simulationsys/citadel/ml/vision/README.md

# Vision ML

Owns crop-specific disease/pest data, lightweight model training, evaluation, and TensorFlow Lite export for the edge device.

Keep raw images out of Git. Version datasets and record the crop, disease classes, and validation metrics with every exported model.
