simulationsys/citadel/docs/CITADEL-SOLUTION-OVERVIEW.md

# Citadel: Complete Solution Overview

## 1. Executive summary

Citadel is an offline-first, AI-assisted smart farming system designed to help farmers understand field conditions early, make better crop-care decisions, and operate irrigation more safely.

The solution combines physical field sensors, cameras, a local edge-computing unit, crop-health AI, pest and environmental-risk intelligence, a farmer mobile application, and an operational web dashboard into one connected system.

Citadel is not merely a sensor dashboard and it is not merely a crop-disease classifier. It creates a complete decision loop:

> Observe the farm, understand the risk, explain what is happening, recommend the next action, obtain human approval where necessary, and verify the result.

The system is designed for farms where internet connectivity may be slow, intermittent, expensive, or completely unavailable. Its essential functions operate locally. Internet connectivity improves synchronization and remote visibility, but the farmer does not lose the core system when the cloud is unavailable.

---

## 2. The problem Citadel addresses

Farm decisions are often made using delayed, incomplete, or disconnected information.

A farmer may notice dry soil only after plants begin showing stress. Crop disease may be recognized only after visible spread. Pest activity may be treated broadly because its source or severity is unclear. Irrigation may depend on habit rather than current soil, rainfall, heat, and water conditions. Existing smart-farming products can also become unusable when internet connectivity fails.

Several underlying problems occur together:

- Field conditions change continuously, but manual inspection is periodic.
- Sensor readings are difficult to interpret without context.
- Disease and pest symptoms may be noticed too late.
- Different tools provide separate readings without producing one clear recommendation.
- Cloud-dependent systems fail in low-connectivity agricultural areas.
- Automated irrigation can become dangerous if recommendations directly control hardware.
- Small and medium farmers need clear actions, not complex analytics.
- Farm managers need a broader operational view than an individual farmer needs.

Citadel addresses these problems as one connected system rather than as isolated features.

---

## 3. The proposed solution

Citadel places a small field node near the crop and a local computing unit, such as a Raspberry Pi, at the farm.

The field node measures conditions such as:

- Soil moisture
- Temperature
- Humidity
- Rainfall or rain conditions
- Tank, channel, or local water level
- Relay and irrigation state

A camera or farmer phone provides crop and pest images. The local computing unit receives this information and combines it using three forms of intelligence:

1. Environmental risk analysis
2. Crop-health image analysis
3. Pest detection or activity analysis

The farmer receives a simple explanation and recommended action through the mobile application. A farm manager or evaluator can see the same underlying farm state through a dashboard with additional history and operational context.

The cloud is optional for the immediate farm loop. When connectivity returns, selected records can synchronize for backup, multi-farm reporting, and remote access.

---

## 4. The complete Citadel loop

```text
Field conditions
      |
      v
Sensors and cameras collect evidence
      |
      v
Local edge unit stores and interprets the evidence
      |
      +--> Environmental risk intelligence
      +--> Crop-health AI
      +--> Pest intelligence
      |
      v
Citadel produces an explainable advisory
      |
      +--> Farmer mobile app: immediate action
      +--> Web dashboard: monitoring and history
      |
      v
Farmer reviews or approves the action
      |
      v
Field hardware performs the approved action
      |
      v
Hardware reports what actually happened
      |
      v
Citadel verifies the outcome and continues monitoring
```

This closed loop is the central idea of Citadel. The system does not stop at collecting data or generating a prediction. It connects observation, decision, action, and verification.

---

## 5. Who the solution serves

### 5.1 Farmer

The farmer is the primary user. The mobile application answers four practical questions:

- What is happening in my field?
- How urgent is it?
- Why is Citadel warning me?
- What should I do next?

The farmer should be able to understand the most important information within a few seconds, without needing to interpret raw sensor charts or machine-learning terminology.

### 5.2 Farm manager or cooperative operator

The dashboard supports someone responsible for a wider operational view. This user may need to compare zones, review recent readings, see alert history, confirm whether devices are online, and monitor irrigation decisions.

### 5.3 Agronomist or agricultural advisor

An advisor can use Citadel's evidence and history to support a more informed inspection. Citadel does not replace expert diagnosis; it helps direct attention earlier and provides the environmental context around a crop-health event.

### 5.4 System or hardware operator

The operator installs sensors, calibrates devices, checks connectivity, maintains the edge unit, and verifies that the relay and pump remain safe during failures.

---

## 6. Hardware scope

### 6.1 ESP32 field node

The ESP32 is the local field controller. It gathers environmental measurements, identifies the device and field zone, and communicates with the local edge unit.

Its purpose is deliberately narrow:

- Read sensors reliably
- Apply calibration
- Detect sensor failure
- Send normalized measurements
- Receive an approved irrigation command
- Control the relay safely
- Report whether the command was actually executed
- Continue sensing during temporary network loss

The ESP32 is not expected to run the main AI models or independently prescribe treatment.

### 6.2 Environmental sensors

Citadel proposes a modular set of sensors so the system can adapt to the farm and available hardware.

Core inputs include:

- A capacitive soil-moisture sensor for water-stress detection
- A temperature and humidity sensor for heat and disease-risk context
- A water-level sensor for tank, channel, or flood monitoring
- A rainfall input when available

The values are treated as evidence, not as unquestionable truth. Sensors must be calibrated and missing sensors must be shown as unavailable rather than replaced with believable-looking values.

### 6.3 Camera system

Citadel can receive images from:

- The farmer's phone
- An ESP32-CAM
- A Raspberry Pi camera
- A fixed pest-trap or canopy camera

Different camera placements serve different purposes. A close leaf image is appropriate for crop-health classification, while a wider fixed view may support pest monitoring.

The image path includes a quality check. Dark, blurry, overexposed, corrupt, or unsuitable images should lead to a recapture request, not a confident diagnosis.

### 6.4 Raspberry Pi or edge computer

The edge computer is the local brain of Citadel. It connects the hardware, AI, storage, applications, and optional cloud.

It is responsible for:

- Receiving readings and images
- Storing recent farm history
- Running local AI
- Combining environmental and visual evidence
- Producing advisories
- Serving the mobile app and dashboard over the local network
- Recording irrigation requests and approvals
- Returning commands to the correct field node
- Synchronizing data when internet access becomes available

The system can initially run on a laptop during development and later move to a Raspberry Pi without changing the overall user experience.

### 6.5 Relay and irrigation equipment

The relay represents the bridge from software advice to a physical action such as switching a pump.

Citadel proposes a human-in-the-loop control model:

1. The system detects a possible irrigation need.
2. Citadel explains the evidence.
3. The farmer reviews the recommendation.
4. The farmer approves or declines it.
5. Only an approved request becomes a command.
6. The field node executes the command.
7. The field node reports the actual relay state.

The safe default is OFF. A recommendation alone must never activate the pump.

---

## 7. Farmer mobile application

The mobile app is Citadel's primary action surface. It is designed around clarity, local use, and weak-connectivity conditions.

### 7.1 Home experience

The home screen presents:

- Current connection and freshness status
- The most urgent advisory
- Essential field measurements
- Quick access to crop scanning
- Irrigation recommendations requiring attention
- Recent changes or important events

Urgent action appears before detailed analytics.

### 7.2 Advisory experience

Each advisory should contain:

- A recognizable category
- Severity or urgency
- A short title
- A plain-language explanation
- The evidence that triggered it
- A suggested next action

For example, Citadel should not only say "Heat risk." It should explain that temperature is high while soil moisture is low and suggest inspection or irrigation during cooler hours.

### 7.3 Crop scan experience

The farmer can capture or select a crop image. Citadel then:

1. Checks whether the image is usable.
2. Runs the appropriate local model.
3. Returns the possible condition and confidence.
4. Clearly communicates uncertainty.
5. Suggests inspection, recapture, or another next step.

The language should remain cautious. A model result is a decision-support signal, not a final agronomic diagnosis.

### 7.4 Irrigation approval experience

When irrigation is recommended, the farmer can inspect the evidence and approve or decline the request.

The interface must distinguish between:

- Recommended
- Approved
- Command sent
- Confirmed by hardware
- Completed or stopped

This prevents the app from claiming that irrigation occurred merely because a button was pressed.

### 7.5 History

The history view helps the farmer understand recent alerts and actions:

- Environmental warnings
- Crop scans
- Pest observations
- Irrigation requests
- Approved or declined actions
- Device or connectivity changes

History is supportive rather than the main focus.

### 7.6 Settings and local connection

The app allows the local edge address and zone to be configured. This lets the farmer's phone connect directly to the Raspberry Pi over farm Wi-Fi without needing public internet access.

Future versions can add Hindi and other regional languages, larger accessibility options, voice guidance, and notifications.

---

## 8. Web dashboard

The web dashboard is the operational view of the same farm intelligence shown in the farmer app.

It is intended for a farm manager, cooperative operator, technical operator, evaluator, or demonstration audience.

The dashboard presents:

- Current sensor readings
- Field or zone status
- Data freshness
- Active advisories
- Latest crop-health observation
- Irrigation and relay state
- Recent reading history
- Device connectivity and service health

The dashboard does not create its own agricultural rules. It displays the same authoritative state and advisories produced by the edge system. This keeps mobile and web recommendations consistent.

Its broader screen size makes it appropriate for trends, comparisons, operational status, and demonstrations. The farmer app remains the simpler field-action experience.

---

## 9. Crop-health AI

Citadel's crop-health intelligence focuses on a credible, limited Phase 1 scope rather than claiming universal crop diagnosis.

The current proposal focuses on tomato leaf health, including categories such as:

- Healthy
- Early blight
- Late blight
- Leaf spot
- Yellow leaf curl virus

The model is designed for local inference so a crop scan can work without a cloud request.

### 9.1 Responsible prediction flow

Before classification, Citadel checks:

- Image resolution
- Brightness
- Overexposure
- Blur
- Whether the image appears to contain a suitable leaf

After prediction, Citadel applies a confidence policy:

- High confidence: present the likely condition with normal caution
- Medium confidence: qualify the result and recommend a clearer close-up or inspection
- Low confidence: return an inconclusive result instead of forcing a disease label
- Invalid image: explain why the image cannot be analyzed

The output becomes one source of evidence for the advisory engine. It does not directly prescribe pesticide use.

---

## 10. Pest intelligence

The pest component is intended to identify or estimate visible pest activity from an image.

Depending on the final model and camera setup, the result may contain:

- Pest category
- Confidence
- Estimated count
- Activity level
- Affected zone
- Image timestamp

Citadel converts this into restrained advice such as inspecting affected plants or using targeted intervention after confirmation.

The system should not claim that a pest model is operational when its trained artifact and matching labels have not been installed and validated. Until that point, the pest feature remains a defined integration capability rather than a production-ready diagnosis.

---

## 11. Environmental-risk intelligence

Citadel combines multiple signals instead of interpreting every sensor independently.

The initial risk categories are:

### 11.1 Irrigation need

Low soil moisture can generate an irrigation recommendation. The farmer is asked to inspect and approve rather than having the pump start automatically.

### 11.2 Heat stress

High temperature combined with dry soil indicates a stronger stress condition than either signal alone. Citadel can recommend inspection and irrigation during a cooler period.

### 11.3 Flood or excess-water risk

High water level or intense rainfall takes priority over irrigation advice. Citadel warns the farmer to inspect drainage and avoid further watering.

### 11.4 Humidity-supported disease risk

Warm, humid conditions can increase disease risk. Citadel recommends inspecting leaves rather than claiming disease solely from environmental conditions.

### 11.5 Pest activity

A sufficiently confident pest observation can create a targeted inspection advisory. Weak detections should not produce strong recommendations.

### 11.6 Combined evidence

The major value comes from combining evidence. For example:

- Dry soil plus high heat produces a stronger heat-stress warning.
- Rain or high water suppresses an otherwise plausible irrigation recommendation.
- Warm humidity plus a suspicious crop image increases the need for inspection.
- A visual pest observation becomes more useful when attached to a specific zone and time.

The current thresholds are demonstration values and must eventually be calibrated for crop, soil, climate, irrigation method, and local agricultural guidance.

---

## 12. Explainability

Citadel is designed to show why it produced an advisory.

Every recommendation should be traceable to evidence such as:

- Soil moisture value
- Temperature and humidity
- Rainfall or water level
- Crop-health label and confidence
- Pest observation and count
- Time and affected zone

This is important because farmers should not be asked to trust a black-box instruction that could affect crops, water use, or equipment.

The system's language should communicate possibility, confidence, and limitations. It should encourage verification before expensive or irreversible treatment.

---

## 13. Offline-first design

Offline-first is a defining property of Citadel, not a fallback added later.

The farm's essential loop is local:

- Sensors communicate with the edge unit over the farm network.
- AI runs on the edge unit.
- Recent data is stored locally.
- The app connects to the edge unit over LAN.
- The dashboard is served locally.
- Advisories are generated locally.
- Irrigation approval does not require the cloud.

If internet access disappears, the system should continue sensing, analyzing, displaying, and controlling approved local actions.

The mobile app retains the last known farm state so it does not become blank during a temporary connection failure. However, cached information must be visibly marked as stale or offline.

When connectivity returns, queued records can synchronize to the cloud without being duplicated.

---

## 14. Cloud role

The cloud is a secondary coordination layer, not the immediate farm brain.

Its proposed responsibilities include:

- Backup of farm events
- Multi-farm visibility
- Remote monitoring
- Aggregated trends
- Long-term history
- Fleet and device management
- Model/version coordination
- Notifications outside the local network

Data created while offline remains on the edge until synchronization becomes possible. Stable event identities allow the cloud to recognize retries and avoid counting the same event twice.

If the cloud is unavailable, the farm should continue operating locally.

---

## 15. Data and information model

Citadel organizes farm information around a few consistent concepts.

### Farm

The overall agricultural location or operational unit.

### Zone

A field, greenhouse section, plot, bed, or monitored area. Every reading, observation, advisory, and command should be associated with the correct zone.

### Device

A stable identity for the physical sensor or camera node.

### Reading

A time-stamped collection of environmental sensor measurements.

### Observation

An AI or external observation such as a crop-health result or pest detection.

### Advisory

An explainable interpretation of readings and observations, including urgency and a suggested next action.

### Irrigation request

A recorded proposal to irrigate. It can remain pending, be approved, be declined, expire, or be completed.

### Actuator state

Citadel distinguishes the state the system wants from the state the hardware actually reports. This difference helps detect failures.

### Event identity

A stable identifier allows retried readings and synchronized records to remain idempotent rather than creating duplicates.

---

## 16. Safety model

Agricultural automation affects physical equipment, water, electricity, and crops. Citadel therefore separates intelligence from authority.

### 16.1 Advice does not equal actuation

The AI and risk engine may recommend irrigation, but they cannot directly turn on the pump.

### 16.2 Human approval

Irrigation requires an explicit approval step unless a future, separately controlled automatic mode is deliberately introduced.

### 16.3 Safe startup

The relay and pump must default to OFF during boot, restart, disconnection, or uncertain state.

### 16.4 Runtime limit

An irrigation command should contain a maximum runtime. The field node must stop the pump after that time even if communication with the edge unit is lost.

### 16.5 Desired versus reported state

The dashboard must not claim that a pump is running only because the backend requested it. The field node must acknowledge what it actually executed.

### 16.6 Sensor failure

A failed sensor should be marked unavailable. Citadel must not convert missing temperature, moisture, or water data into a realistic default and then generate advice from it.

### 16.7 AI uncertainty

Low-quality or low-confidence images produce an inconclusive result or recapture request. They must not create confident diagnoses.

### 16.8 Treatment boundary

Citadel recommends inspection and targeted action. It does not independently prescribe chemical treatment.

---

## 17. Failure behavior

Citadel proposes predictable behavior for common failures.

| Failure | Expected Citadel behavior |
| --- | --- |
| Internet unavailable | Continue the complete local farm loop |
| Cloud unavailable | Queue synchronization and retry later |
| Edge unit temporarily unreachable | Field node continues sampling and retries |
| Phone loses the edge connection | Show the last known state as stale, not live |
| Sensor fails | Mark it unavailable and exclude it from rules requiring that sensor |
| Image is poor | Request a better image |
| Crop model unavailable | Report that analysis is unavailable |
| Pest model unavailable | Report that the model is not ready |
| Duplicate reading | Accept safely without storing it twice |
| Irrigation command is not acknowledged | Show a desired/reported mismatch and keep the system safe |
| Edge unit crashes during irrigation | Field node runtime limit stops the pump |
| Hardware restarts | Relay returns to OFF |

---

## 18. End-to-end user journeys

### 18.1 Dry-soil journey

1. The soil sensor detects low moisture.
2. The ESP32 sends the reading to the edge unit.
3. Citadel checks rainfall, water level, and heat before recommending irrigation.
4. The app shows an irrigation warning and its evidence.
5. The farmer inspects the field.
6. The farmer approves or declines the request.
7. If approved, the command reaches the field node.
8. The field node activates the relay for a limited period.
9. The node reports the relay state.
10. Later readings show whether soil moisture improved.

### 18.2 Crop-disease journey

1. The farmer notices a suspicious leaf.
2. The farmer captures a close-up image in the app.
3. Citadel checks image quality.
4. The local crop model returns a likely class and confidence.
5. The result is combined with environmental context.
6. The farmer receives a cautious inspection advisory.
7. The observation enters local history for later comparison or expert review.

### 18.3 Pest journey

1. A farmer or fixed camera captures possible pest activity.
2. Citadel validates the image and runs the installed pest model.
3. The detection is attached to a zone and time.
4. Weak evidence is ignored or shown as uncertain.
5. Stronger evidence creates a targeted inspection advisory.
6. The farmer verifies the affected plants before treatment.

### 18.4 Flood-risk journey

1. Rainfall or water level rises.
2. Citadel identifies excess-water risk.
3. Flood risk takes priority over dry-soil irrigation logic.
4. The farmer receives a critical drainage warning.
5. Irrigation is avoided while the risk remains.

### 18.5 Offline journey

1. Internet access disappears.
2. Sensors continue sending data to the local edge unit.
3. Local AI and advisories continue operating.
4. The farmer app and dashboard remain available on the farm network.
5. Records accumulate locally.
6. When the internet returns, pending records synchronize to the cloud.

---

## 19. Current physical and product status

### Hardware currently demonstrated

- ESP32-WROOM-32 field-node foundation
- DHT11 temperature/humidity sensor wired and tested
- HC-SR04 water-level sensor wired through a voltage divider and tested
- Relay control side wired and tested
- Relay held OFF on boot
- Sensor JSON visible through the serial monitor

### Hardware still pending

- Capacitive soil-moisture sensor purchase, wiring, and calibration
- Rainfall-sensor decision and integration
- Raspberry Pi arrival and deployment
- Physical pump/load integration
- Final relay terminal and polarity verification before pump use
- Wi-Fi transmission from the ESP32 to the edge unit
- Command acknowledgement and hardware runtime protection
- Camera-node integration

### Mobile app currently represented

- Farmer-focused Flutter application
- Home, advisory, scan, history, profile, and settings experiences
- Configurable edge address and zone
- Live-repository structure with cached-state fallback
- Mock fallback for demonstrations and interface development

The complete phone-to-edge journeys still require final end-to-end contract verification with the consolidated backend and physical device.

### Dashboard currently represented

- Local browser dashboard
- Sensor and advisory presentation
- Crop-health and irrigation demo controls
- Same-origin operation from the edge service

### Crop-health AI currently represented

- Tomato-focused MobileNetV2/TensorFlow Lite artifacts
- Five crop-health classes
- Image-quality gate
- Confidence and limitation policy
- Training, evaluation, and audit artifacts

### Pest intelligence currently represented

- Pest inference adapter and integration boundary
- Risk rules capable of consuming pest observations
- Honest unavailable state when no final pest artifact is installed

The final pest detector and matching labels remain required for real pest inference.

### Edge and cloud currently represented

- Consolidated Python-based edge service
- Local persistent event storage
- Farm-state, readings, observations, history, crop-health, irrigation, and actuator flows
- Delayed edge-to-cloud synchronization boundary
- Cloud-side idempotent batch ingestion
- Backend test and CI coverage

---

## 20. MVP scope

The credible Citadel MVP should demonstrate one complete, reliable farm loop rather than a large number of incomplete features.

The MVP includes:

- One farm and at least one zone
- One functioning ESP32 field node
- Temperature and humidity readings
- Soil-moisture reading after sensor integration
- Water-level or rainfall risk input
- Local edge processing
- Tomato crop-health scan
- Environmental advisories
- Mobile display of farm state and urgent action
- Web dashboard display of the same state
- Human-approved relay demonstration using a safe test load
- Offline operation without public internet
- Optional delayed cloud synchronization

The MVP does not need to claim:

- Universal crop support
- Fully autonomous irrigation
- Agronomist-grade diagnosis
- Production-ready chemical recommendations
- Large multi-farm fleet management
- A completed pest model before a validated artifact exists
- Fully weatherproof, solar-powered field deployment

---

## 21. Demonstration narrative

A strong demonstration should tell one continuous story.

1. Show the physical field node and live sensor values.
2. Show the same values arriving at the local Citadel edge unit.
3. Open the farmer app and dashboard to prove both receive one shared farm state.
4. Create a dry-soil scenario and show an explainable irrigation recommendation.
5. Show that the relay remains unchanged until the farmer approves.
6. Approve the request and demonstrate relay activation with a safe load.
7. Show hardware acknowledgement or clearly state that it is the next integration step.
8. Capture or upload a tomato-leaf image.
9. Show image-quality validation, prediction, confidence, limitation, and advisory.
10. Create a high-water or rainfall condition and show that flood risk overrides irrigation.
11. Disconnect public internet and repeat a local reading or scan.
12. Explain that cloud synchronization resumes later without interrupting the farm.

This demonstration proves that Citadel is a connected decision system rather than a collection of unrelated prototypes.

---

## 22. Key differentiators

### Offline-first rather than cloud-dependent

The farm remains functional without internet access.

### One shared intelligence layer

The farmer app and dashboard receive the same state and recommendations instead of implementing separate rules.

### Multi-modal evidence

Citadel combines environmental sensors, images, pest observations, and hardware state.

### Explainable recommendations

The system shows the evidence behind its advice.

### Human-controlled actuation

AI recommends; the farmer authorizes consequential physical actions.

### Closed-loop verification

Citadel distinguishes a requested action from what the hardware actually performed.

### Honest uncertainty

Poor images, missing sensors, unavailable models, and stale data are surfaced rather than hidden.

### Modular growth path

New crops, zones, sensors, models, languages, and farms can be added without changing the basic product loop.

---

## 23. Expected benefits

Citadel aims to deliver practical benefits rather than only technical novelty.

- Earlier awareness of crop stress
- Better-timed irrigation
- Reduced unnecessary water use
- Faster inspection of possible disease or pest activity
- More targeted intervention
- Lower dependence on continuous connectivity
- Improved traceability of farm decisions
- Safer interaction between AI recommendations and physical equipment
- A clearer shared picture for farmers, managers, and advisors
- A foundation for long-term farm intelligence

These are expected benefits that require field validation. The project should measure them rather than present them as guaranteed outcomes.

---

## 24. Field-validation plan

Technical correctness alone is not enough. Citadel should be validated through controlled field scenarios.

### Sensor validation

- Compare moisture readings against dry and saturated reference conditions.
- Compare temperature and humidity against a trusted device.
- Measure water-level accuracy at known distances.
- Record sensor behavior during disconnection and noise.

### Advisory validation

- Review thresholds with an agricultural expert.
- Test conflicting signals such as dry soil during heavy rain.
- Verify that missing sensors do not create false advisories.
- Record farmer understanding of each recommendation.

### AI validation

- Keep a separated test set.
- Test healthy and diseased leaves in real lighting.
- Include blurry, dark, distant, and non-leaf images.
- Track false positives, false negatives, and inconclusive rates.
- Validate pest-model output against the final camera placement.

### Usability validation

- Measure how quickly a farmer identifies the required action.
- Test labels, icons, colors, and language comprehension.
- Confirm that stale and offline states are understood.
- Ensure approval status is not confused with completed irrigation.

### Safety validation

- Restart every component while the relay is connected to a safe test load.
- Disconnect Wi-Fi during an irrigation command.
- Test duplicate and delayed commands.
- Verify runtime shutoff independently of the Raspberry Pi.
- Connect a real pump only after low-voltage tests pass.

---

## 25. Expansion roadmap

### Near-term completion

- Complete ESP32 Wi-Fi communication
- Add and calibrate the soil-moisture sensor
- Deploy the edge system to the Raspberry Pi
- Finish camera upload integration
- Validate the farmer-app/backend journeys
- Add command acknowledgement and a hardware dead-man timer
- Complete the safe relay demonstration
- Install and validate a real pest model
- Clean up outdated documentation and freeze the shared product vocabulary

### Product expansion

- Hindi and regional-language support
- Voice-guided advisories
- Push or local notifications
- Multiple farm zones
- Multiple field nodes
- Farmer-defined crops and risk profiles
- Weather forecast integration when online
- Agronomist review and escalation
- Treatment and inspection logs
- Seasonal trend analysis
- Water-use measurement
- Yield and intervention outcome tracking

### Platform expansion

- Multi-farm cloud dashboard
- Cooperative and FPO management
- Fleet health and device provisioning
- Remote configuration
- Secure model updates
- Role-based access
- Strong device authentication
- Encrypted data synchronization
- Audit trails and operational monitoring
- Integration with government, insurance, or agricultural advisory systems where appropriate

---

## 26. Scope boundaries and responsible claims

Citadel is a decision-support and farm-monitoring platform. It should be presented honestly.

Citadel can claim that it:

- Collects and combines local farm evidence
- Generates explainable risk advisories
- Supports local crop-image analysis
- Operates its core loop without public internet
- Keeps irrigation behind explicit approval
- Provides mobile and dashboard views
- Supports delayed cloud synchronization

Citadel should not yet claim that it:

- Diagnoses every disease or crop
- Guarantees yield improvement
- Replaces an agronomist
- Prescribes pesticides autonomously
- Safely controls a real pump without completed hardware validation
- Detects pests without a validated pest model
- Is production-ready for unattended agricultural automation

Clear boundaries strengthen the credibility of the solution.

---

## 27. Final solution statement

Citadel proposes a practical agricultural intelligence system built around the realities of field use: incomplete connectivity, imperfect sensors, uncertain images, limited farmer attention, and the physical consequences of automation.

Its value is not any single sensor, model, application, or dashboard. Its value is the connection between them:

> A trustworthy local system that observes the field, combines evidence, explains risk, supports the farmer's decision, safely coordinates action, and learns from what happens next.

That is the complete Citadel solution.
