simulationsys/citadel/docs/field-node-wiring-diagram.html

Citadel · Smart Farming · Field Node

# ESP32 Sensor & Actuator Wiring

Built from your actual kit — substitutions for DHT11, resistor values, and the missing rain gauge are called out below, not glossed over.

Zone: zone‑a · Device: field‑node‑01
Logic: ESP32 GPIO, 3.3V
Rev. 2026‑09‑08

## What you have vs. what the circuit needs

Component | Your kit | Wired to | Note
ESP32‑WROOM‑32 | Have | — | Center of the circuit, all logic is 3.3V.
Capacitive soil moisture v1.2 | To buy | AOUT → GPIO34 | ₹120. Skip the resistive two‑prong kind — it corrodes in soil within days.
DHT11 (swap for DHT22) | Substitute | DATA → GPIO4 | 0–50°C, ±2°C, 20–90% RH. Fine for a demo; re‑check readings above ~45°C field temps.
HC‑SR04 ultrasonic | Have | TRIG → GPIO32 ECHO → GPIO33 | ECHO is 5V — must pass through the divider, never straight to GPIO33.
Tipping‑bucket rain gauge | Not available | GPIO15 (spare) | See substitution note below — use an analog raindrop board, or report rainfallMm: 0 for the demo.
5V 1‑ch relay module | Have | IN → GPIO26 | Pump wired through NO + COM only. Never NC.
Mini pump | Have | via relay load side | Runs off its own supply, switched by the relay — never straight off ESP32.
5.6kΩ resistor ×2 (swap for 10kΩ) | Substitute | DHT11 pull‑up | Two in series ≈ 11.2kΩ — close enough to the 10kΩ pull‑up spec.
1kΩ resistor ×3 (swap for 1kΩ+2kΩ) | Substitute | HC‑SR04 divider | 1 alone (1kΩ) + 2 in series (2kΩ) reproduces the exact 1:2 divider ratio.
Raspberry Pi 4 | Arriving later | — | Run the edge API on your laptop meanwhile — same code, just swap the IP in firmware once the Pi lands.

## Connection diagram

ESP32 field node: soil moisture, DHT11, and HC‑SR04 feed sensor data in; a relay switches the mini pump. The HC‑SR04’s 5V echo passes through a 1kΩ/2kΩ divider (built from your three 1kΩ resistors) before reaching GPIO33. Rain gauge input is left unwired — GPIO15 stays free for it.

Power (3.3V solid / 5V dashed) Ground Signal to GPIO Resistor

## Substitution notes for your kit

### DHT11 instead of DHT22

Wire identically to DHT22 — VCC to 3.3V, DATA to GPIO4 with the pull‑up, GND to ground. Firmware only needs the Adafruit DHT library set to DHT11 instead of DHT22. Expect noisier readings and a 50°C ceiling; fine for an indoor/demo run.

### 5.6kΩ ×2 instead of 10kΩ

Two 5.6kΩ resistors in series give ≈11.2kΩ, close enough for the DHT pull‑up — it isn’t a precision value, just needs to be in the 4.7–12kΩ range.

### 1kΩ ×3 instead of 1kΩ+2kΩ

Use one 1kΩ from ECHO to the junction, and two 1kΩ in series (=2kΩ) from the junction to GND. Same 1:2 ratio as the spec → 5V × (2kΩ/3kΩ) = 3.33V at GPIO33. Safe.

### No tipping‑bucket rain gauge

Two options: (1) buy a cheap analog raindrop board (₹80–100) wired to GPIO15 as an ADC input, mapped to an approximate mm scale; or (2) for the demo, hardcode rainfallMm: 0 in firmware and narrate the flood scenario using the water‑level sensor instead — the advisory engine already treats waterLevelPct >= 75 as flood risk on its own.

### Raspberry Pi not here yet

Run npm run dev:edge on your laptop and point the firmware’s EDGE_API_URL at your laptop’s LAN IP. When the Pi arrives, everything moves over by changing that one URL and running the same command there.

Citadel field node · docs/hardware-wiring-guide.md & docs/iot-sensor-integration-guide.md have the full step‑by‑step and firmware reference.
