simulationsys/citadel/firmware/esp32-field-node/config.example.h

// Copy this file to field_node/config.h — next to field_node.ino, which is what
// the Arduino IDE compiles — and fill in your own values.
//
// field_node/config.h is gitignored and must stay uncommitted. Wi-Fi
// credentials do not belong in the repository.

#define WIFI_SSID     "your-network"
#define WIFI_PASSWORD "your-password"

// The Raspberry Pi's LAN address and the consolidated edge API's port.
// Never "localhost" or 127.0.0.1 — on the ESP32 those resolve to the ESP32.
#define EDGE_API_URL "http://192.168.1.31:3001/v1/readings"

#define DEVICE_ID "field-node-01"
#define ZONE_ID   "zone-a"

// Must match actuator_id_for(zone) in services/edge-api/app/db.py.
// zone-a keeps the historical id; other zones are "pump-<zoneId>".
#define EXPECTED_ACTUATOR_ID "pump-relay-01"

// Set these from the physical build before flashing. An absent sensor is
// omitted from the API payload and appears as `--` in the Flutter app.
#define WIFI_ENABLED true
#define SOIL_SENSOR_WIRED false

// Rainfall remains unavailable until a real gauge and calibrated reader are
// implemented. The Flutter app will show `--` for this metric in the meantime.

// Verify using the relay board LED with no pump/load attached. Many common
// relay modules are active-low, in which case set this to false.
#define RELAY_ACTIVE_HIGH true
