simulationsys/citadel/(commit log)

2026-08-30 Set up app webapp Arduino and ML workspaces
2026-09-01 Document phased integration flow
2026-09-08 docs: add field node progress and wiring diagrams, refactor firmware structure
2026-09-09 feat(backend): implement unified edge and cloud services (Phases 1-4)
    - Phase 1: Package citadel_pest_risk, support nullable sensor values, frozen ADVISORY_TYPES
    - Phase 2: Consolidate backend to single FastAPI on port 3001, SQLite WAL migration, unified endpoints
    - Phase 3: Connect vision inference bridge to ml/vision, pre-flight checks and typed exceptions
    - Phase 4: Implement FastAPI services/cloud-api with idempotent batch push sync and replay protection
2026-09-09 feat: wire crop-health AI + irrigation control into farmer app, add Wokwi diagram
    - Point farmer app at the live Python backend (port 3000) instead of the
    unused Node edge-api (3001), matching where the ESP32 actually posts
    - Add POST /v1/crop-health to the dashboard backend: runs a submitted leaf
    photo through the real ml/vision TFLite model via subprocess, with a
    graceful inconclusive fallback if AI deps aren't installed
    - Rewire the app's irrigation approve/decline flow to call the backend's
    actual /v1/actuator-command endpoint instead of endpoints that don't exist
    - Document AI dependency weight for the Pi 3B+ separately (requirements-vision.txt)
    - Add a Wokwi diagram.json matchi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
2026-09-09 fix: Pi-native crop inference, Flutter contract bugs, firmware relay downlink
    Backend:
    - Crop-health inference now prefers tflite-runtime over full TensorFlow,
    caches the interpreter per process, and validates tensor shape/class
    count against the model's own metadata sidecar.
    - Infrastructure failures (missing runtime/model, bad tensors) now map to
    a distinct exit code and a 503, never a fake 'inconclusive' result.
    - /health now reports the actual model artifact used (v1.1) instead of
    a stale unversioned copy, plus which TFLite runtime would be selected.
    Flutter:
    - Removed the silent mock-data fallback: an unreachable edge node now
    shows as unreachable instead of rendering invente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
    [config.example.h, field_node.ino]
2026-09-09 feat: complete offline hardware and camera AI demo
